rahulr0702/nimbus-2000-esp32-micro-drone/README.md

# nimbus-2000-esp32-micro-drone
Custom ESP32-S3 micro-quadcopter featuring a standard X-frame layout, custom PCB design in KiCad, MPU6050 motion sensing, and VL53L0X distance sensing.
