rahulr0702/nimbus-2000-esp32-micro-drone/hardware/renders/nimbus-2000-v1-BackCopper-Render.png

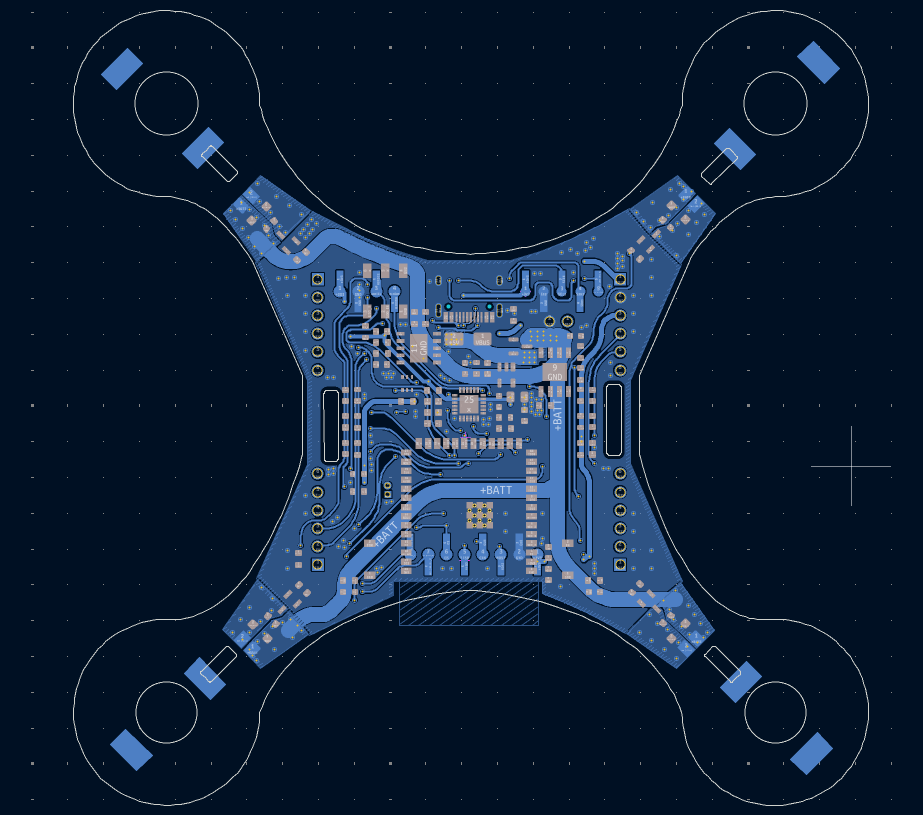
hardware/renders/nimbus-2000-v1-BackCopper-Render.png
