rahulr0702/nimbus-2000-esp32-micro-drone/hardware/schematics/nimbus-2000-v1-SoC-schematic.png

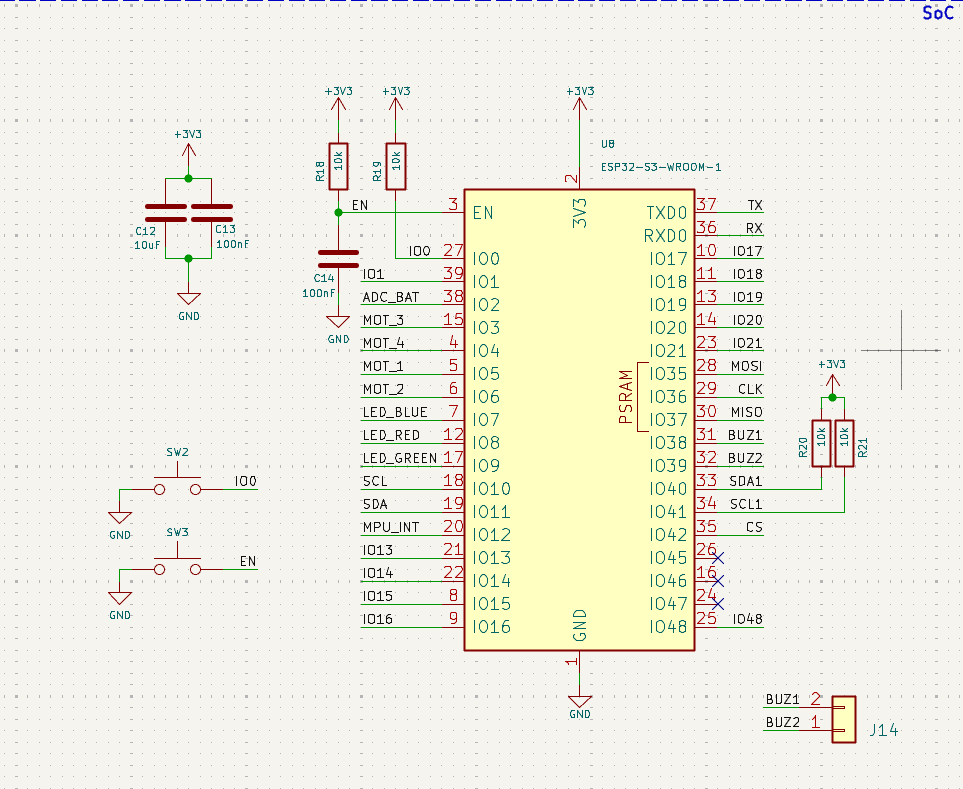
hardware/schematics/nimbus-2000-v1-SoC-schematic.png
